Zulolo/sh-z-004/sch/SCH_sh-z-004.pdf

R18 | 4.7K C⁴ ¹⁰⁰nF | C⁶ ¹⁰⁰nF

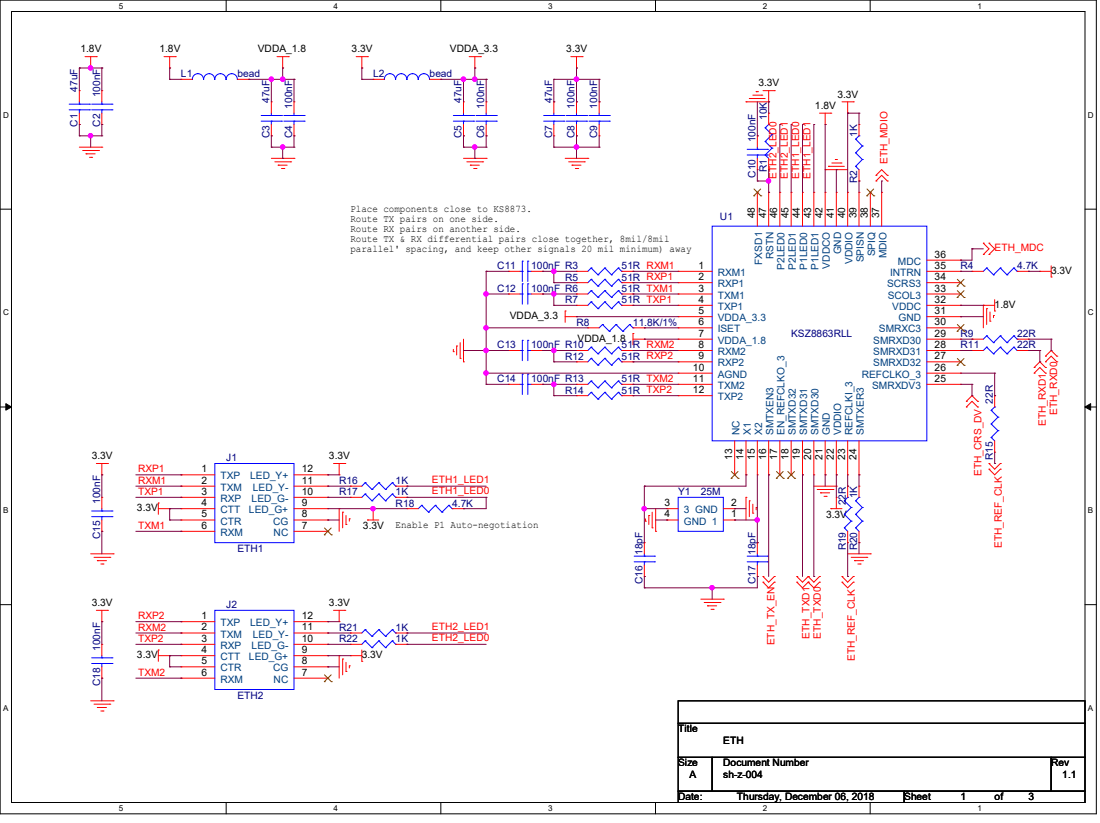
[picture p14: page 1]

Place components close to KS8873.
Route TX pairs on one side.
Route RX pairs on another side.
Route TX & RX differential pairs close together, 8mil/8mil
parallel' spacing, and keep other signals 20 mil minimum) away

+Vo L3 | 6.8uH | 4 R³⁴ ⁵¹⁰R

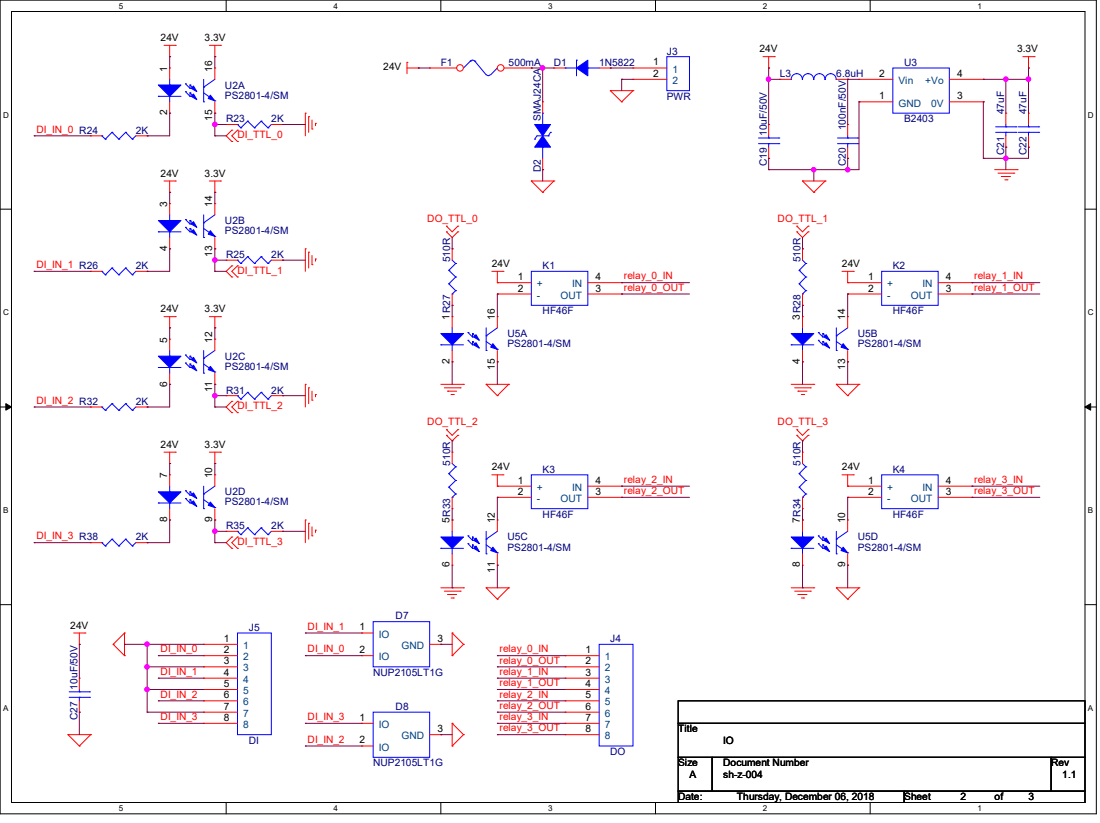
[picture p15: page 2]

R43 | 1.5K C²⁹ ¹⁰⁰nF | C³³ ¹⁰⁰nF

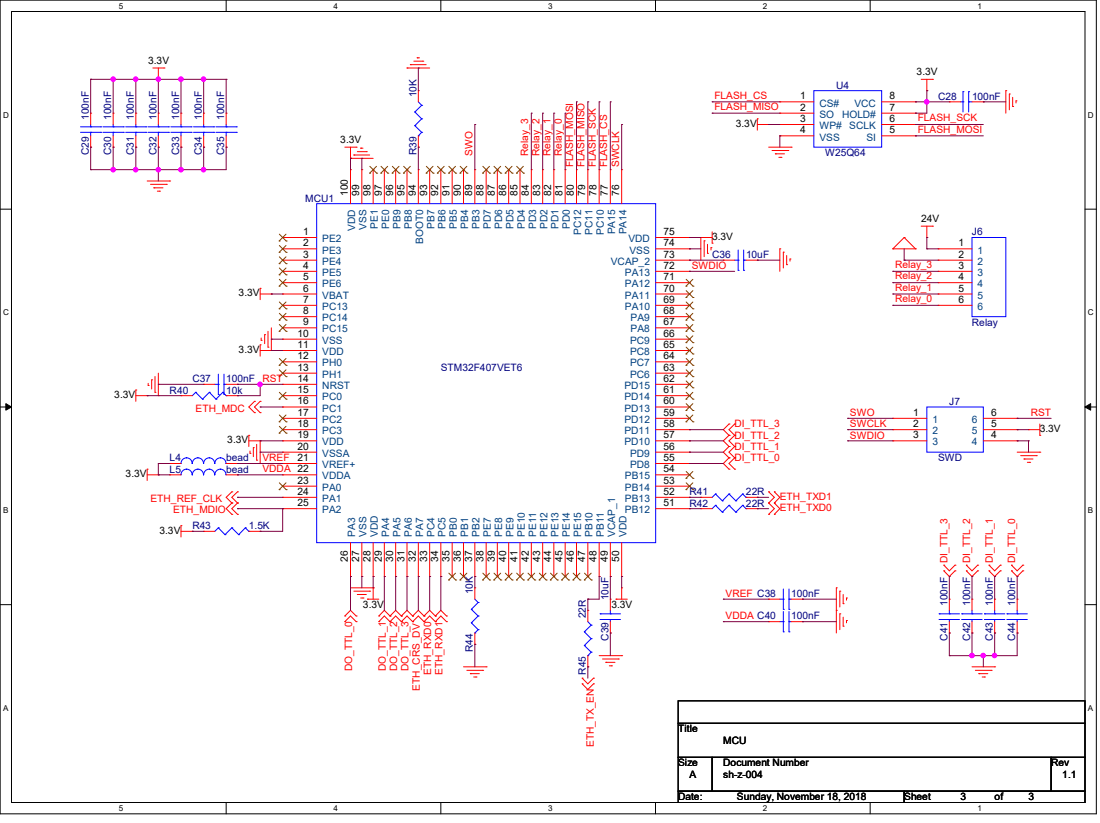
[picture p16: page 3]
