Zulolo/sh-z-004/(list of files, drawings)

Other design files:
sch/IO_TWO_ETH.DSN
sch/io_two_eth.opj
