Zulolo/sh-z-004/code/io_2eth_stm32f4/Src/main.c

/**
  ******************************************************************************
  * @file           : main.c
  * @brief          : Main program body
  ******************************************************************************
  * This notice applies to any and all portions of this file
  * that are not between comment pairs USER CODE BEGIN and
  * USER CODE END. Other portions of this file, whether 
  * inserted by the user or by software development tools
  * are owned by their respective copyright owners.
  *
  * Copyright (c) 2018 STMicroelectronics International N.V. 
  * All rights reserved.
  *
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
  ******************************************************************************
  */
/* Includes ------------------------------------------------------------------*/
#include "main.h"
#include "stm32f4xx_hal.h"
#include "cmsis_os.h"
#include "lwip.h"

/* USER CODE BEGIN Includes */
#include "spi_flash.h"
#include "spiffs.h"
#include "lwip/apps/tftp_server.h"
#include "di_monitor.h"
#include "utility.h"

/* USER CODE END Includes */

SPI_HandleTypeDef hspi3;
DMA_HandleTypeDef hdma_spi3_rx;
DMA_HandleTypeDef hdma_spi3_tx;

TIM_HandleTypeDef htim7;

osThreadId defaultTaskHandle;
osThreadId modbus_tcpHandle;
osThreadId di_monitorHandle;
osThreadId webserverHandle;
osTimerId GARP_TimerHandle;
osMutexId DO_DataAccessHandle;
osMutexId DI_DataAccessHandle;
osMutexId SpiffsMutexHandle;
osMutexId SpiFlashChipMutexHandle;
osMutexId WebServerFileMutexHandle;

/* USER CODE BEGIN PV */
EventGroupHandle_t xDiEventGroup;
EventGroupHandle_t xComEventGroup;

extern struct netif gnetif;
extern spiffs SPI_FFS_fs;
extern const struct tftp_context TFTP_Ctx;
/* USER CODE END PV */

void SystemClock_Config(void);
static void MX_GPIO_Init(void);
static void MX_DMA_Init(void);
static void MX_TIM7_Init(void);
static void MX_SPI3_Init(void);
void StartDefaultTask(void const * argument);
extern void start_modbus_tcp_server(void const * argument);
extern void start_di_monitor(void const * argument);
extern void start_webserver(void const * argument);
void send_GARP(void const * argument);

/* USER CODE BEGIN PFP */
extern void UTL_start_udp_broadcast(void const * argument);
/* USER CODE END PFP */

/* USER CODE BEGIN 0 */
//static void send_GARP(void const * argument) {
////	printf("send GARP timer enter\n");
//	etharp_gratuitous(&gnetif);
////	printf("send GARP timer leave\n");
//}

/* USER CODE END 0 */

/**
  * @brief  The application entry point.
  *
  * @retval None
  */
int main(void)
{
  /* MCU Configuration----------------------------------------------------------*/

  /* Reset of all peripherals, Initializes the Flash interface and the Systick. */
  HAL_Init();

  /* Configure the system clock */
  SystemClock_Config();

  /* Initialize all configured peripherals */
  MX_GPIO_Init();
  MX_DMA_Init();
  MX_TIM7_Init();
  MX_SPI3_Init();
  /* Create the mutex(es) */
  /* definition and creation of DO_DataAccess */
  osMutexDef(DO_DataAccess);
  DO_DataAccessHandle = osMutexCreate(osMutex(DO_DataAccess));

  /* definition and creation of DI_DataAccess */
  osMutexDef(DI_DataAccess);
  DI_DataAccessHandle = osMutexCreate(osMutex(DI_DataAccess));

  /* definition and creation of SpiffsMutex */
  osMutexDef(SpiffsMutex);
  SpiffsMutexHandle = osMutexCreate(osMutex(SpiffsMutex));

  /* definition and creation of SpiFlashChipMutex */
  osMutexDef(SpiFlashChipMutex);
  SpiFlashChipMutexHandle = osMutexCreate(osMutex(SpiFlashChipMutex));

  /* definition and creation of WebServerFileMutex */
  osMutexDef(WebServerFileMutex);
  WebServerFileMutexHandle = osMutexCreate(osMutex(WebServerFileMutex));

  /* USER CODE BEGIN RTOS_MUTEX */
  /* add mutexes, ... */
  xDiEventGroup = xEventGroupCreate();
  if( xDiEventGroup == NULL ) {
    printf("DI event group create failed.\n");
  }
  xComEventGroup = xEventGroupCreate();
  if( xComEventGroup == NULL ) {
    printf("Communication event group create failed.\n");
  }  
  
  /* USER CODE END RTOS_MUTEX */

  /* USER CODE BEGIN RTOS_SEMAPHORES */
  /* add semaphores, ... */
  /* USER CODE END RTOS_SEMAPHORES */

  /* Create the timer(s) */
  /* definition and creation of GARP_Timer */
  osTimerDef(GARP_Timer, send_GARP);
  GARP_TimerHandle = osTimerCreate(osTimer(GARP_Timer), osTimerPeriodic, NULL);

  /* USER CODE BEGIN RTOS_TIMERS */
  /* start timers, add new ones, ... */
	

  /* USER CODE END RTOS_TIMERS */

  /* Create the thread(s) */
  /* definition and creation of defaultTask */
  osThreadDef(defaultTask, StartDefaultTask, osPriorityNormal, 0, 512);
  defaultTaskHandle = osThreadCreate(osThread(defaultTask), NULL);

  /* definition and creation of modbus_tcp */
  osThreadDef(modbus_tcp, start_modbus_tcp_server, osPriorityIdle, 0, 256);
  modbus_tcpHandle = osThreadCreate(osThread(modbus_tcp), NULL);

  /* definition and creation of di_monitor */
  osThreadDef(di_monitor, start_di_monitor, osPriorityIdle, 0, 512);
  di_monitorHandle = osThreadCreate(osThread(di_monitor), NULL);

  /* definition and creation of webserver */
  osThreadDef(webserver, start_webserver, osPriorityIdle, 0, 256);
  webserverHandle = osThreadCreate(osThread(webserver), NULL);

  /* USER CODE BEGIN RTOS_THREADS */
  /* add threads, ... */
  /* USER CODE END RTOS_THREADS */
	osThreadDef(udp_discovery, UTL_start_udp_broadcast, osPriorityIdle, 0, 256);
  webserverHandle = osThreadCreate(osThread(udp_discovery), NULL);
  /* USER CODE BEGIN RTOS_QUEUES */
  /* add queues, ... */
  
  
  /* USER CODE END RTOS_QUEUES */
 

  /* Start scheduler */
  osKernelStart();
  
  /* We should never get here as control is now taken by the scheduler */

  /* Infinite loop */
  /* USER CODE BEGIN WHILE */

  while (1)
  {

  /* USER CODE END WHILE */

  /* USER CODE BEGIN 3 */

  }
  /* USER CODE END 3 */

}

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
/* USER CODE BEGIN Header_StartDefaultTask */
/**
  * @brief  Function implementing the defaultTask thread.
  * @param  argument: Not used 
  * @retval None
  */
/* USER CODE END Header_StartDefaultTask */
void StartDefaultTask(void const * argument)
{
	printf("Main app default task start.\n");
	spiffs_init();
	UTL_sh_z_004_info_init();
	UTL_sh_z_eth_conf_init();
  /* init code for LWIP */
  MX_LWIP_Init();

  /* USER CODE BEGIN 5 */
	osTimerStart(GARP_TimerHandle, 5000);
	xEventGroupSetBits(xComEventGroup, EG_ETH_NETIF_UP_BIT );
	tftp_init(&TFTP_Ctx);	
  /* Infinite loop */
  for(;;)
  {
    osDelay(5000);
  }
  /* USER CODE END 5 */ 
}

/* send_GARP function */
void send_GARP(void const * argument)
{
  /* USER CODE BEGIN send_GARP */
  etharp_gratuitous(&gnetif);
  /* USER CODE END send_GARP */
}

/**
  * @brief  Period elapsed callback in non blocking mode
  * @note   This function is called  when TIM1 interrupt took place, inside
  * HAL_TIM_IRQHandler(). It makes a direct call to HAL_IncTick() to increment
  * a global variable "uwTick" used as application time base.
  * @param  htim : TIM handle
  * @retval None
  */
void HAL_TIM_PeriodElapsedCallback(TIM_HandleTypeDef *htim)
{
  if (htim->Instance == TIM1) {
    HAL_IncTick();
  }
}

/**
  * @brief  This function is executed in case of error occurrence.
  * @param  file: The file name as string.
  * @param  line: The line in file as a number.
  * @retval None
  */
void _Error_Handler(char *file, int line)
{
  /* USER CODE BEGIN Error_Handler_Debug */
  /* User can add his own implementation to report the HAL error return state */
  while(1)
  {
  }
  /* USER CODE END Error_Handler_Debug */
}

#ifdef  USE_FULL_ASSERT
/**
  * @brief  Reports the name of the source file and the source line number
  *         where the assert_param error has occurred.
  * @param  file: pointer to the source file name
  * @param  line: assert_param error line source number
  * @retval None
  */
void assert_failed(uint8_t* file, uint32_t line)
{ 
  /* USER CODE BEGIN 6 */
  /* User can add his own implementation to report the file name and line number,
     tex: printf("Wrong parameters value: file %s on line %d\r\n", file, line) */
  /* USER CODE END 6 */
}
#endif /* USE_FULL_ASSERT */

/**
  * @}
  */

/**
  * @}
  */

/************************ (C) COPYRIGHT STMicroelectronics *****END OF FILE****/
