Zulolo/sh-z-004/code/io_2eth_stm32f4/io_2eth_stm32f4.ioc

Mcu.UserName=STM32F407VETx
PA1.Signal=ETH_REF_CLK
PA13.Signal=SYS_JTMS-SWDIO
PA14.Signal=SYS_JTCK-SWCLK
PA15.GPIO_Label=SPI_FLASH_CS
PA15.Signal=GPIO_Output
PA2.Signal=ETH_MDIO
PA3.GPIO_Label=DO_0
PA3.Signal=GPIO_Output
PA4.GPIO_Label=DO_1
PA4.Signal=GPIO_Output
PA5.GPIO_Label=DO_2
PA5.Signal=GPIO_Output
PA6.GPIO_Label=DO_3
PA6.Signal=GPIO_Output
PA7.Signal=ETH_CRS_DV
PB11.Signal=ETH_TX_EN
PB12.Signal=ETH_TXD0
PB13.Signal=ETH_TXD1
PB3.Signal=SYS_JTDO-SWO
PC1.Signal=ETH_MDC
PC10.Signal=SPI3_SCK
PC11.Signal=SPI3_MISO
PC12.Signal=SPI3_MOSI
PC4.Signal=ETH_RXD0
PC5.Signal=ETH_RXD1
PD0.GPIO_Label=RELAY_0
PD0.Signal=GPIO_Output
PD1.GPIO_Label=RELAY_1
PD1.Signal=GPIO_Output
PD10.GPIO_Label=DI_2
PD10.Signal=GPXTI10
PD11.GPIO_Label=DI_3
PD11.Signal=GPXTI11
PD2.GPIO_Label=RELAY_2
PD2.Signal=GPIO_Output
PD3.GPIO_Label=RELAY_3
PD3.Signal=GPIO_Output
PD8.GPIO_Label=DI_0
PD8.Signal=GPXTI8
PD9.GPIO_Label=DI_1
PD9.Signal=GPXTI9
