Zulolo/sh-z-004/pcb/nc_param.txt

INTEGER-PLACES         2
DECIMAL-PLACES         5
X-OFFSET               0.000000
Y-OFFSET               0.000000
FEEDRATE               1
COORDINATES            ABSOLUTE
OUTPUT-UNITS           METRIC
TOOL-ORDER             INCREASING
REPEAT-CODES           YES
SUPPRESS-LEAD-ZEROES   NO
SUPPRESS-TRAIL-ZEROES  NO
SUPPRESS-EQUAL         NO
TOOL-SELECT            NO
OPTIMIZE_DRILLING      NO
ENHANCED_EXCELLON      NO
HEADER                 none
LEADER                 12
CODE                   ASCII
SEPARATE               NO
SEPARATE-ROUTING       NO
DRILLING               LAYER-PAIR
BACKDRILL              NO
COUNTER                NO
CAVITY                 NO
TOLERANCE_DRILL        NO
TOLERANCE_TRAVEL       YES
TOOL_SIZE              YES
ROTATION               NO
NON_STANDARD           YES
TOTAL_DRILL            YES
SEPARATE_SLOT          NO
SUPPRESS_TOLERANCE     YES
SUPPRESS_TOOLSIZE      YES
SUPPRESS_ROTATION      NO
