Zulolo/sh-z-004/code/io_2eth_stm32f4/Src/httpserver-socket.c

/**
  ******************************************************************************
  * @file    LwIP/LwIP_HTTP_Server_Socket_RTOS/Src/httpserver-socket.c
  * @author  MCD Application Team
  * @brief   Basic http server implementation using LwIP socket API   
  ******************************************************************************
  * @attention
  *
  * <h2><center>&copy; Copyright (c) 2017 STMicroelectronics International N.V. 
  * All rights reserved.</center></h2>
  *
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
  ******************************************************************************
  */
/* Includes  -----------------------------------------------------------------*/
#include "lwip/sys.h"
#include "lwip/sockets.h"
#include "lwip/apps/fs.h"
#include "string.h"
#include "httpserver-socket.h"
#include "cmsis_os.h"
#include "spiffs.h"
#include <stdio.h>

/* Private typedef -----------------------------------------------------------*/
/* Private define ------------------------------------------------------------*/
#define WEBSERVER_THREAD_PRIO    ( osPriorityAboveNormal )

/* Private macro -------------------------------------------------------------*/
/* Private variables ---------------------------------------------------------*/
portCHAR PAGE_BODY[512];
extern spiffs SPI_FFS_fs;
extern osMutexId WebServerFileMutexHandle;

/* Format of dynamic web page: the page header */
static const unsigned char PAGE_START[] = {
0x3c,0x21,0x44,0x4f,0x43,0x54,0x59,0x50,0x45,0x20,0x68,0x74,0x6d,0x6c,0x20,0x50,
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

/**
  * @brief serve tcp connection  
  * @param conn: connection socket 
  * @retval None
  */
void http_server_serve(int conn) 
{
	int buflen = 1500;
	int ret;
	struct fs_file file;
	static unsigned char recv_buffer[1500];

	/* Read in the request */
	ret = read(conn, recv_buffer, buflen); 
	if(ret < 0) return;
	//	write(conn, "sh-z-002 web server test", (size_t)sizeof("sh-z-002 web server test") + 1);
	//	close(conn);
	//	return;
	/* Check if request to get ST.gif */
	if ((strncmp((char *)recv_buffer,"GET /index.html",sizeof("GET /index.html") - 1)==0) || 
		(strncmp((char *)recv_buffer, "GET / ", 6) == 0) ) {
		fs_open(&file, "/index.html"); 
		write(conn, (const unsigned char*)(file.data), (size_t)file.len);
		fs_close(&file);
	} else if(strncmp((char *)recv_buffer, "GET /files", sizeof("GET /files") - 1) == 0) {
	/* Load dynamic page */
		dyn_web_page_list_files(conn);
	} else {
		spiffs_file tFileDesc; 
		int32_t res;
		char cFileName[16];
		memset(cFileName, 0, sizeof(cFileName));
		sscanf((char *)recv_buffer, "GET /%15s HTTP", cFileName);
		osMutexWait(WebServerFileMutexHandle, osWaitForever);
		tFileDesc = SPIFFS_open(&SPI_FFS_fs, cFileName, SPIFFS_RDONLY, 0);
		if (tFileDesc >= 0) {
			while((res = SPIFFS_read(&SPI_FFS_fs, tFileDesc, (uint8_t *)recv_buffer, sizeof(recv_buffer))) > 0) {
				write(conn, (uint8_t *)recv_buffer, res);
			}
			SPIFFS_close(&SPI_FFS_fs, tFileDesc);
			osMutexRelease(WebServerFileMutexHandle);
		} else {
			osMutexRelease(WebServerFileMutexHandle);
			/* Load 404 page */
			fs_open(&file, "/404.html");
			write(conn, (const unsigned char*)(file.data), (size_t)file.len);
			fs_close(&file);		  
		}

	}
	/* Close connection socket */
	close(conn);
}

/**
  * @brief  http server thread 
  * @param arg: pointer on argument(not used here) 
  * @retval None
  */
void http_server_socket_thread(void *arg)
{
  int sock, newconn, size;
  struct sockaddr_in address, remotehost;

 /* create a TCP socket */
  if ((sock = socket(AF_INET, SOCK_STREAM, 0)) < 0) 
  {
    return;
  }
  
  /* bind to port 80 at any interface */
  address.sin_family = AF_INET;
  address.sin_port = htons(80);
  address.sin_addr.s_addr = INADDR_ANY;

  if (bind(sock, (struct sockaddr *)&address, sizeof (address)) < 0)
  {
    return;
  }
  
  /* listen for incoming connections (TCP listen backlog = 5) */
  listen(sock, 5);
  
  size = sizeof(remotehost);
  
  while (1) 
  {
    newconn = accept(sock, (struct sockaddr *)&remotehost, (socklen_t *)&size);
    http_server_serve(newconn);
  }
}

/**
  * @brief  Create and send a dynamic Web Page. This page contains the list of 
  *         running tasks and the number of page hits. 
  * @param  conn connection socket
  * @retval None
  */
void dyn_web_page_list_files(int conn)
{
	uint32_t total, used;
	int32_t res;
	spiffs_DIR d;
	struct spiffs_dirent e;
	struct spiffs_dirent *pe = &e;

	memset(PAGE_BODY, 0,512);

	strcat((char *) PAGE_BODY, "<pre><br>Files in flash" );
	strcat((char *) PAGE_BODY, "<br>---------------------------------------------<br>"); 

	/* The list of tasks and their status */
	res = SPIFFS_info(&SPI_FFS_fs, &total, &used);
	if (res >= 0) {
		sprintf(PAGE_BODY + strlen(PAGE_BODY), "Used: %u bytes in total: %u bytes", used, total);	
	}

	strcat((char *) PAGE_BODY, "<br>"); 
	SPIFFS_opendir(&SPI_FFS_fs, "/", &d);
	while ((pe = SPIFFS_readdir(&d, pe)) != NULL) {
		sprintf(PAGE_BODY + strlen(PAGE_BODY), "%s [%04x] size:%i<br>", pe->name, pe->obj_id, pe->size);
	}
	SPIFFS_closedir(&d);
	strcat((char *) PAGE_BODY, "<br><br>---------------------------------------------"); 

	/* Send the dynamically generated page */
	write(conn, PAGE_START, strlen((char*)PAGE_START));
	write(conn, PAGE_BODY, strlen(PAGE_BODY));
}

/************************ (C) COPYRIGHT STMicroelectronics *****END OF FILE****/
