Zulolo/sh-z-004/code/io_2eth_stm32f4/modified/fsdata.c

#include "lwip/apps/fs.h"
#include "lwip/def.h"
#include "fsdata.h"


#define file_NULL (struct fsdata_file *) NULL

static const unsigned int dummy_align__404_html = 1;
static const unsigned char data__404_html[] = {
/* /404.html (10 chars) */
0x2f,0x34,0x30,0x34,0x2e,0x68,0x74,0x6d,0x6c,0x00,0x00,0x00,

/* HTTP header */
/* "HTTP/1.0 404 File not found
" (29 bytes) */
0x48,0x54,0x54,0x50,0x2f,0x31,0x2e,0x30,0x20,0x34,0x30,0x34,0x20,0x46,0x69,0x6c,
0x65,0x20,0x6e,0x6f,0x74,0x20,0x66,0x6f,0x75,0x6e,0x64,0x0d,0x0a,
/* "Server: lwIP/1.3.1 (http://savannah.nongnu.org/projects/lwip)
" (63 bytes) */
0x53,0x65,0x72,0x76,0x65,0x72,0x3a,0x20,0x6c,0x77,0x49,0x50,0x2f,0x31,0x2e,0x33,
0x2e,0x31,0x20,0x28,0x68,0x74,0x74,0x70,0x3a,0x2f,0x2f,0x73,0x61,0x76,0x61,0x6e,
0x6e,0x61,0x68,0x2e,0x6e,0x6f,0x6e,0x67,0x6e,0x75,0x2e,0x6f,0x72,0x67,0x2f,0x70,
0x72,0x6f,0x6a,0x65,0x63,0x74,0x73,0x2f,0x6c,0x77,0x69,0x70,0x29,0x0d,0x0a,
/* "Content-type: text/html

" (27 bytes) */
0x43,0x6f,0x6e,0x74,0x65,0x6e,0x74,0x2d,0x74,0x79,0x70,0x65,0x3a,0x20,0x74,0x65,
0x78,0x74,0x2f,0x68,0x74,0x6d,0x6c,0x0d,0x0a,0x0d,0x0a,
/* raw file data (565 bytes) */
0x3c,0x68,0x74,0x6d,0x6c,0x3e,0x3c,0x68,0x65,0x61,0x64,0x3e,0x3c,0x74,0x69,0x74,
0x6c,0x65,0x3e,0x53,0x48,0x2d,0x5a,0x2d,0x30,0x30,0x32,0x3c,0x2f,0x74,0x69,0x74,
0x6c,0x65,0x3e,0x3c,0x2f,0x68,0x65,0x61,0x64,0x3e,0x3c,0x62,0x6f,0x64,0x79,0x20,
0x62,0x67,0x63,0x6f,0x6c,0x6f,0x72,0x3d,0x22,0x77,0x68,0x69,0x74,0x65,0x22,0x20,
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
file_NULL,
data__404_html,
data__404_html + 12,
sizeof(data__404_html) - 12,
1,
}};

const struct fsdata_file file__index_html[] = { {
file__404_html,
data__index_html,
data__index_html + 12,
sizeof(data__index_html) - 12,
1,
}};

#define FS_ROOT file__index_html
#define FS_NUMFILES 2
