Zulolo/sh-z-004/(commit log)

2018-10-15 finish PCB layout
    [art_param.txt, io_4di_4do.brd, nc_param.txt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]
2018-10-21 start with mcu code
    [io_two_eth.opj]
2018-11-17 use opt to deal with diff GND issue
    [IO_TWO_ETH.DSN, io_4di_4do.brd, io_two_eth.opj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]
2018-12-06 change optocoupler If R from 1K to 510R
    [IO_TWO_ETH.DSN, io_4di_4do.brd, io_two_eth.opj]
2018-12-06 change eth LED If R to 1K
    [IO_TWO_ETH.DSN, io_two_eth.opj]
